GICM-UdeA/Horno-CS/README.md

# Horno-CS
Este proyecto esta encaminado a el diseño y construcción de un horno de secado para celdas solares flexibles. Documentos e información relevante pueden consultarse en la [carpeta compartida][carpeta] de OneDrive de GICM. En este [enlace][docInfo] encontrará los detalles del proyecto que fueron suministrados por el grupo de celdas solares. 

> [!NOTE]
> **Actualización 16-Mayo**  
> Se estudio la forma de construir el Horno propuesto. El desarrollo y resultados de dicho estudio pueden consultarse en el directorio [`concept_test/`](https://github.com/GICM-UdeA/Horno-CS/tree/main/concept-test). Sin embargo, los objetivos del proyecto se cambiaron para enfocarse solamente en desarrollar un sistema de caracterización de los perfiles de temperatura que alcanza un Horno o sistema de radiación. La propuesta y desarrollo de esto último se puede consultar en el directorio [`measurement-system/`](https://github.com/GICM-UdeA/Horno-CS/tree/main/measurement-system).

>**CONTRIBUCIONES Y REPORTE DE PROBLEMAS**
>
> Si eres desarrollador, para tratar de preservar la integridad del repositorio y evitar fallos, por favor seguir las pautas para publicar aportaciones, las cuales se indican en el apartado ["CONTRIBUTING"][contributors]. Si encuentra algún problema dentro del proyecto puede reportarlo abriendo un "issue" de acuerdo con los lineamientos del mismo apartado.



[contributors]: CONTRIBUTING.mb
[docInfo]: https://docs.google.com/document/d/1KgRByXrc8A7OMcjD5w7Hg8IoM0wxuoulxKGeyv_lWE0/edit?usp=sharing
[carpeta]: https://docs.google.com/document/d/1KgRByXrc8A7OMcjD5w7Hg8IoM0wxuoulxKGeyv_lWE0/edit?usp=sharing
