GICM-UdeA/Horno-CS/img/A4988_conection.jpg

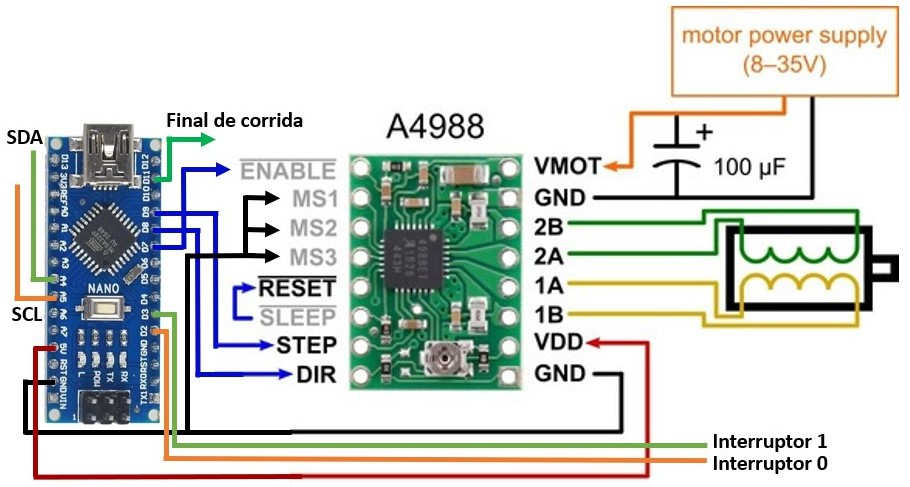
img/A4988_conection.jpg
