GICM-UdeA/Horno-CS/img/master_thermocouple.jpg

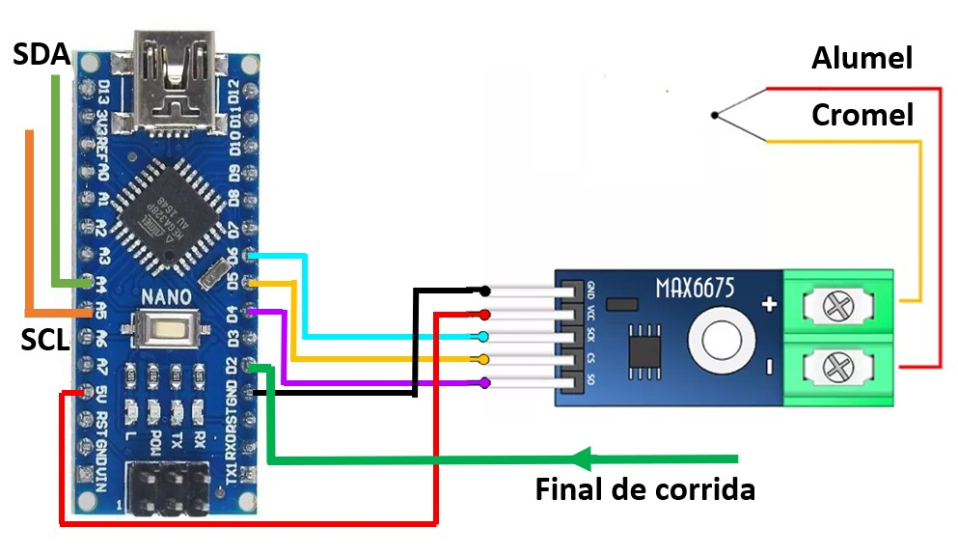
img/master_thermocouple.jpg
