GICM-UdeA/Horno-CS/concept-test/software/interface-py/map_test.png

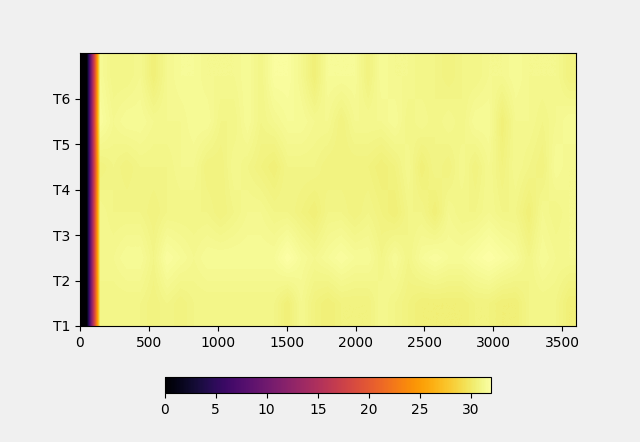
concept-test/software/interface-py/map_test.png
