GICM-UdeA/Horno-CS/concept-test/software/interface-py/plot_test.png

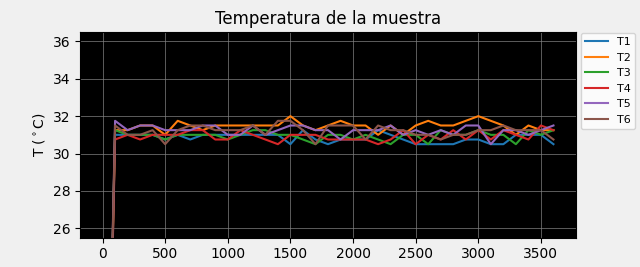
concept-test/software/interface-py/plot_test.png
