GICM-UdeA/Horno-CS/concept-test/software/interface-py/plotPID_test.png

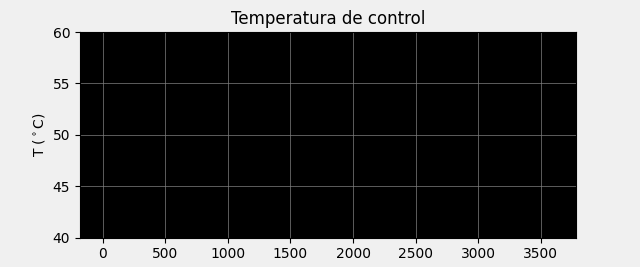
concept-test/software/interface-py/plotPID_test.png
