GICM-UdeA/Horno-CS/concept-test/software/interface-py/results/map_test.png

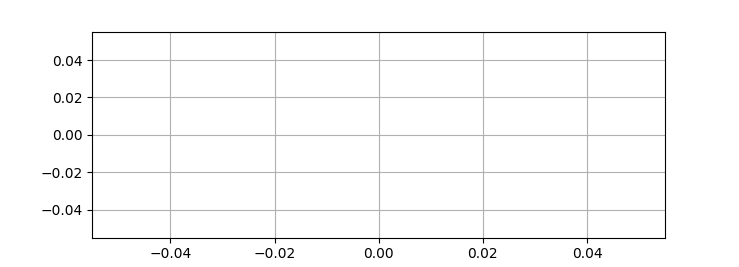
concept-test/software/interface-py/results/map_test.png
