GICM-UdeA/Horno-CS/img/measures1.jpg

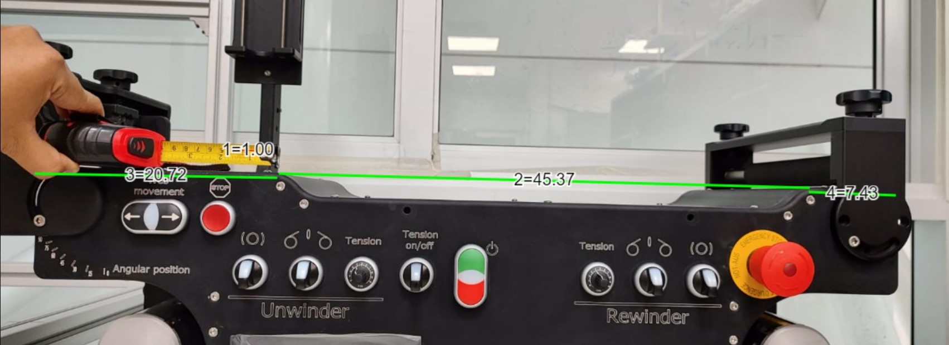
img/measures1.jpg
