GICM-UdeA/Horno-CS/img/measures2.jpg

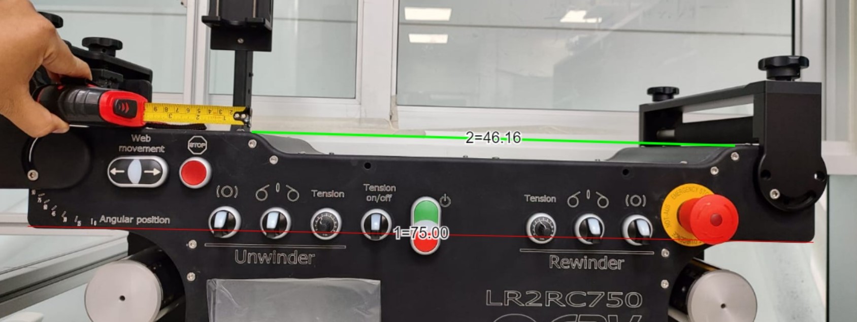
img/measures2.jpg
