GICM-UdeA/Horno-CS/(threads)

Thread 1 (2023-09-09):

Desarrollar Dimmer digital controlado por PWM

DanielEstrada971102, 2023-09-09:
Para el control de la intensidad de la fuente de luz se querría un sistema que pueda ser controlado digitalmente. Se puede implementar un circuito Dimmer con estás características basándose en lo que se ilustra [acá](https://www.learningelectronics.net/circuits/dimmer-with-mosfet.html).

DanielEstrada971102, 2023-09-29:
Se plantea la posibilidad de desarrollar otro montaje basado en este [video](https://www.youtube.com/watch?v=4Dd16clsMxQ)

DanielEstrada971102, 2023-10-24:
Un análisis más detenido del problema permitió notar que dos aspectos muy importantes de este circuito son el Transistor MOSFET que se utilice y/o el optoacoplador. Idealmente se recomienda tratar de apegarse al diseño original de la referencia, ya que estuvimos mucho tiempo atascados para finalmente darnos cuenta que usando el optoacoplador "4n33" en conjunto con el transistor IRF180 no reproduce el comportamiento deseado del circuito.  Esto se debe, básicamente, a que el transistor tiene un requerimiento alto de corriente de GATE que no se satisface, por lo tanto, no se satura el transistor.

Esto se resolvió usando otro Optoacoplador que cumpla el requerimiento del transistor. Al final se utilizó el "PC817" y junto con el IRF, !si funcionó!

Para resolver este problema fue de gran utilidad ver el siguiente hilo de [reddit](https://www.reddit.com/r/AskElectronics/comments/lsnehx/simple_mosfet_pwm_circuit_in_falstad_is_only/).

Básicamente el circuito implementado funciona como esto: [https://tinyurl.com/y7s5d6m3](https://tinyurl.com/y7s5d6m3)

Closed 2023-10-24.

Thread 2 (2023-09-09):

Arreglar el sistema del motor

DanielEstrada971102, 2023-09-09:
EL circuito y el código que controla el motor, y por lo tanto el movimiento de la termocupla con la muestra de PET, se desarrolló y ensayo exitosamente. Sin embargo, luego de un tiempo dejo de trabajar, se sospecha que pudo haberse quemado un componente. Se requiere revisar el sistema y determinar si efectivamente se trata de un cambio de componente electrónico o si por el contrarío se trata de algo en la codificación.

DanielEstrada971102, 2023-09-15:
Después de revisar el circuito no se encontró ningún problema en la electrónica. Inspeccionando el código se notó que el problema radicaba en la forma en la que el dispositivo maestro envía los comandos al esclavo (motor).

Closed 2023-09-15.

Thread 3 (2023-09-09):

Idear un sistema de medición de temperatura en tiempo real para el sustrato de las celdas

DanielEstrada971102, 2023-09-09:
En el sistema final se pretende medir de forma directa la temperatura del sustrato de las celdas solares (PET), para ello se ha considerado diseñar un sistema en forma de rodillo que integre sensores de temperatura al rededor de la circunferencia. De esta forma se mediría la temperatura del PET por contacto directo con el rodillo.

Este diseño representa varios desafíos, el más obvio es el hecho de que si los sensores son cableados, al estar atados en un rodillo giratorio estos se van a retorcer y sería imposible conectarlo a un microcontrolador. La idea hasta ahora, sería diseñar el rodillo hueco, de tal forma que se pueda incrustar en el interior toda la electrónica necesaria.

Esto es un problema abierto, **mejores soluciones pueden ser planteadas**.

DanielEstrada971102, 2024-03-14:
Dado el nuevo enfoque del proyecto, la medición directa en el sustrato de la celda se ha descartado. Por ahora con la caracterización de la radiación con el sistema de termocuplas implementado en #22 será suficiente. Este issue se cierra por el momento.

Closed 2024-03-14.

Thread 5 (2023-09-18):

Rehacer el control de velocidad del motor

DanielEstrada971102, 2023-09-18:
Hasta ahora la velocidad a la que gira el motor, y por ende, la velocidad a la que se mueve la base del motor, se basa en el calculo que indica la ecuación (1) en ["Motor de paso"](concept-test/firmware/Motor_code/README.md). Allí se tiene control de las revoluciones por minuto que se le indican al programa y arduino traduce está información a tamaño de pulso. Se cree que es mejor alternativa idear como modificar el programa para que en lugar de pasarle el valor pwm, se le pase la velocidad en unidades m/min (considere que se quiere un sistea que sea capaz de moverse en el rango 0.05-2.8 m/min.

La idea es que al finalizar, en la interfaz,  se pueda mandar el valor de la velocidad en m/min.

DanielEstrada971102, 2023-09-25:
Al parecer la libreria Stteper.h de arduino integra la funcionalidad de control de velocidad. La idea sería cambiar en el código del motor, la forma en la que se controla la velocidad.

Closed 2024-02-24.

Thread 6 (2023-09-18):

Construir la interfaz para la prueba de conceptos

DanielEstrada971102, 2023-09-18:
Para facilitar la manipulación y visualización de los datos de las pruebas de conceptos, se pensó construir una interfaz grafica para interactuar con el arduino maestro del sistema. La idea sería hacer algo muy simple y fácil de implementar, entonces se puede usar Python o LabView

Closed 2023-09-23.

Thread 7 (2023-09-18):

Incluir los comandos de control del Dimmer en el código del maestro

DanielEstrada971102, 2023-09-18:
Luego de que se resuelva el issue #1 se tendrá que incluir las respectivas opción de control para el subsistema de control de intensidad de radiación. Sería añadir los respectivos comandos a el código [master_code.ino](concept-test/firmware/master_code/master_code.ino).

DanielEstrada971102, 2023-10-24:
Este Issue está contenido en el #10, por lo tanto se cierra acá.

Closed 2023-10-24.

Thread 9 (2023-09-29):

¿Cuál es el precio de horno del LR2RC?

DanielEstrada971102, 2023-09-29:
Consultar el precio de mercado del horno que se requiere para el sistema.

DanielEstrada971102, 2023-09-29:
Consultado en la pagina del proveedor de estos instrumentos InfinityPV, se encuentra el siguiente catálogo:

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

Thread 10 (2023-10-10):

Construir sistema de radiación IR

DanielEstrada971102, 2023-10-10:
Avanzando un paso hacia un versión prototipo más realista del horno, se debe construir un sistema de calentamiento por radiación infrarroja. Para ellos se plantea el montaje de la figura.

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

La potencia de las lamparás se debería poder variar por medio de un circuito tipo Dimmer controlado por el Arduino con señales PWM (ver issue #1 y ver [video](https://www.youtube.com/watch?v=4Dd16clsMxQ)). La idea sería añadir también un control PID a este sistema, de tal forma que se mantenga estable la temperatura configurada (ver [video](https://www.youtube.com/watch?v=NVwsOzVxZAk&t=315s)).

La caracterización del plano de incidencia de la radiación podría tratar de medirse con un Luxómetro, aún hay que pensar más al respecto para tratar de garantizar que toda la superficie reciba la misma intensidad y se caliente uniformemente.

DanielEstrada971102, 2024-01-25:
Usando transistores MOSFET con referencia IRF840 se supera el limite de potencia del encapsulado si se usan más de dos lámparas halógenas (~1kW) . por lo tanto se sugiere usar dos de 500W cómo máximo o añadir al circuito etapas de potencia extra, es decir, un transistor por lámpara a usar. El circuito que se está usando al momento se ilustra en la siguiente imagen:

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

Como puede notarse, se introdujo una etapa de "*switcheo*" extra a través de un transistor 2N2222A, esto, tratado de mitigar el elevado consumo de potencia.

Nota: Los componentes clave que se usan en el circuito de la imagen son solo con fines de simulación, los del circuito real corresponden a los mencionados en #1.

DanielEstrada971102, 2024-01-30:
Para evitar el rediseño del circuito para preparar etapas de potencia para cada lampara por separado, se optó por usar solo dos lámparas halógenas en está etapa de prueba de concepto.

La construcción del horno se logro al fabricar una cavidad metálica (ver figura) en cuyo interior se recubrió con lana de roca como aislante térmico. De esta forma, se han logrado alcanzar temperaturas de más de 200 °C.

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

El sistema de control PID se programo con éxito y presenta el comportamiento deseado. El siguiente paso será calibrarlo para estabilizar las temperaturas "setPoint" y para que las fluctuaciones no sean abruptas.

DanielEstrada971102, 2024-02-01:
resuelto con el commit 0902145

Closed 2024-02-07.

Thread 12 (2024-01-31):

Calibrar el controlador PID del horno

DanielEstrada971102, 2024-01-31:
Como se discutió en el issue #10 , el código de base para el control PID del horno y el prototipo para las pruebas de concepto se desarrollaron de manera exitosa. El siguiente paso será hacer la calibración de los parámetros PID para garantizar un mejor funcionamiento del horno. Luego de esto hay que integrarlo al código principal.

DanielEstrada971102, 2024-03-14:
Dado que el enfoque del proyecto cambio para solo desarrollar un sistema de medición, este issue se cierra por ahora.

Closed 2024-03-14.

Thread 14 (2024-02-07):

Actualizar la interfaz grafica de LabView para control el horno

DanielEstrada971102, 2024-02-07:
Con el issue #10 y el pull-request #13 se deja listo el sistema de radiación o prototipo de Horno. Con esa nueva característica la interfaz debe adaptarse.

Closed 2024-02-24.

Thread 17 (2024-02-24):

Incluir más termocuplas en el sistema de medición

DanielEstrada971102, 2024-02-24:
Apuntando a construir un sistema de medición en tiempo real del mapa de temperaturas en el plano por el que avanza una muestra al atravesar el horno (ver figura), se pretende incluir al sistema de detección `master_code.ino` más entradas de termocuplas. Ante el requerimiento de pines, se cree que es necesario migrar a una tarjeta Arduino Mega.

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

La modificación al código consiste en producir una salida (como respuesta al comando `g`) con la siguiente estructura:
```python
out_data = {"T1": [v1], "T2": [v2], "T3": [v3], "T4": [v4], "T⁵": [v5]}
```
con `[v_i]` la medida de cada termocupla.

DanielEstrada971102, 2024-02-27:
@Sosorio8894, se descartó la necesidad de adquirir el Arduino Mega. Esto, porque los drivers de las termocuplas (MAX6675) se comunican con el microcontrolador a través del protocolo SPI, esto quiere decir que requiere de las tres líneas (cables) de comunicación (SCK, CS, S0 ), de las cuales, dos pueden compartirse entre varios dispositivos esclavos (cada controlador MAX...), y la restante (CS) se conecta en un pin digital del arduino para cada driver. Este pin es el que le permite al arduino escoger con que dispositivo comunicarse.

En este link hay detalles sobre el proceso.
[Multiple-SPI-devices-to-an-arduino-microcontroller](https://www.learningaboutelectronics.com/Articles/Multiple-SPI-devices-to-an-arduino-microcontroller.php)

Pero para una aproximación simplificada se puede ver este post que trata sobre conectar dos MAX6675 al arduino.
[interfacing-multiple-max6675-with-arduino-uno](https://forum.arduino.cc/t/interfacing-multiple-max6675-with-arduino-uno/960114/4)

Closed 2024-03-07.

Thread 18 (2024-02-24):

Adapatar la interfaz grafica de Python

DanielEstrada971102, 2024-02-24:
De acuerdo al cambio que se propone implementar en #17, se requiere adaptar la interfaz grafica de 9dc777bea4f70c6b5ba27701f98c738ac80f15bf. Se debe producir el mapa de temperaturas a lo largo del movimiento de la muestra al atravesar el horno.

Closed 2024-03-18.

Thread 20 (2024-02-29):

Modificar la librería MAX6675

DanielEstrada971102, 2024-02-29:
Dado que la librería max6675 de Adafruit no utiliza de forma directa la librería SPI de Arduino, no permite hacer una conexión directa de varios dispositivos SPI esclavos para resolver el issue #17. Se hace necesario entonces, crear una clase personalizada que resuelva el problema. La modificación a hacer es la propuesta en este [foro](https://arduino.stackexchange.com/questions/37193/multiple-3-wire-spi-sensor-interfacing-with-arduino)

Closed 2024-02-29.

Thread 23 (2024-03-14):

Diseñar la PCB universal

DanielEstrada971102, 2024-03-14:
Dada las limitaciones de tiempo, el circuito final se debe implementar en una PCB universal. Para ello se propone hacer un esquema del diseño que tendrá el circuito para poder planear la compra de materiales, incluyendo el tipo de conexiones y las medidas de la caja que contendrá el sistema.

Para el diseño se propone usar softwares como [atarado soft circuit editor](https://bricotronika.blogspot.com/2015/09/atarado-soft-circuit-editor.html) o [DIY Layout creator](https://diy-fever.com/software/diylc/), que permiten hacer diseños como

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

Adicional al PCB se debe planear la compra de una caja plástica para guardar el sistema y cómo se deben hacer las perforaciones.

DanielEstrada971102, 2024-03-20:
Se vuelve a abrir este issue debido a un cambió que debe hacerse en el diseño. Debido a la dificultad para encontrar conectores de termocupla a buen precio, se decide implementar la conexión por medio de un conector DB15.

Closed 2024-03-20.

Thread 24 (2024-03-14):

Cotizar y comprar materiales

DanielEstrada971102, 2024-03-14:
Cuando se resuelva el issue #23, debe hacerse rápidamente el proceso de cotización y compra de componentes y materiales.

DanielEstrada971102, 2024-03-16:
@Sosorio8894 con la publicación del Pull-request #30, se establecieron los materiales a comprar. Puedes proceder con la cotización de estos. Acá dejo de nuevo la lista.

- [ ] 1 Caja plástica para proyectos ~12 x 12 ( i+d 150x95x50mm)
- [ ] 1 Circuito impreso universal 5x7cm PCB-BQ-7X5
- [ ] 1 MJ180CH Jack DC De Chasis 2.1×5.5mm
- [ ] 1 ADAPTADOR DE VOLTAJE 5V 2A CONECTOR JACK 5.5 mm
- [ ] 1 Bornera Macho Para PCB De 2 Pines
- [ ] 1 interruptor - Switch balancín mini 2 pines
- [ ] 10 conectores Header hembra 6 pines - 2.54mm (0.1 inch)
- [ ] 3 conectores Header hembra 6 pines - 2.54mm (0.1 inch)
- [ ] 1 metro de temoencogible 2 cm
- [ ] 6 módulos MAX6675
- [ ] 7 termocupla tipo k
- [ ] 6 Conectores de termopar de montaje en Panel - hembra (tipo k)
- [ ] 7 (x10 unidades c/u) cables hembra-macho dupont 10cm. Ver si hay monocolor, si sí, dos monocolor al menos.
- [ ] 1 modulo Bluetooth HC05
- [ ] 2 metro de cable UTP (cable rígido)
- [ ] 6 Separadores (pilares) plástico M/H M4 de 10mm
- [ ] 6 Tuerca plástica M4
- [ ] 4 Separador plástico M/H M2 de 6mm
- [ ] 4 Tuerca metálica para tornillo M2
- [ ] 2 Fresa de tungsteno para CNC 1mm
- [ ] 1 SINTESOLDA Pegante epóxico
- [ ] 1 cinta doble cara

DanielEstrada971102, 2024-03-22:
De la lista mencionada solo falta comprar:

- [ ] 1 SINTESOLDA Pegante epóxico
- [ ] 1 cinta doble cara
- [ ] 1 conector [DB15](https://suconel.com/product/conector-db15-hembra-de-15-pines-rs15h/) hembra 2 hileras

Closed 2024-04-10.

Thread 25 (2024-03-14):

Armar la PCB del sistema, poner en su caja y diseñar las pegatinas decorativas

DanielEstrada971102, 2024-03-14:
Se debe ensamblar el sistema diseñado en #23 y poner en una caja del tamaño apropiado.

Adicionalmente se debe diseñar algunas laminas decorativas que se peguen al sistema con el Logo e información del grupo.

Closed 2024-04-17.

Thread 26 (2024-03-14):

Diseñar membrana o soporte para el arreglo de termocuplas

DanielEstrada971102, 2024-03-14:
La idea para el sistema es censar en tiempo real la temperatura de la cavidad del horno a través de un arreglo de termocuplas con geometría no restringida. Es decir, que las termocuplas puedan organizarse en la geometría que se desee. Para ello se plantea el diseño o la construcción de una membrana agujereada de forma regular, de tal forma que los diferentes termopares se puedan organizar en los agujeros a conveniencia. En arreglos por ejemplo de 2x3, 3x2, 6x1, etc. . El material puede ser el mismo PET provisto por el grupo de celdas, esto con el fin de tener una estructura liviana y que en principio soporte la temperatura que será aplicada.

NOTA: se puede considerara la necesidad de pintar la membrana de negro mate junto con las termocuplas, esto para tratar de optimizar la absorción de radiación.

Thread 27 (2024-03-14):

Implementar el Firmware definitivo del sistema de medición de temperatura.

DanielEstrada971102, 2024-03-14:
El código a implementar en el Arduino debe satisfacer los siguientes requerimientos.

* Monitorear hasta 6 termocuplas tipo k (amplificadas por el módulo MAX6675) de forma eficiente usando el protocolo SPI.
* Comiscarse por protocolo serial con la computadora para enviar los registros de temperatura al recibir el comando "g". Cómo respuesta a esa petición, el sistema debe responder con la siguiente estructura.
  ```python
  {"T1": [T1 value], "T2": [T2 value], "T3": [T3 value], "T4": [T4 value], "T5": [T5 value], "T6": [T6 value]}
  ```
* Dependiendo de lo que se defina posteriormente, podría llegar a ser necesario implementar la comunicación via Bluetooth.

NOTA: La implementación de un código definitivo implicará, por supuesto, tener una versión de firmware capaz de controlar todo el sistema de movimiento y control del Horno. Esto para poder testear el sistema.

DanielEstrada971102, 2024-03-19:
Apuntando a escribir algo optimizado se puede plantear el almacenamiento de las mediciones en una cola de memoria con [ArduinoQueue](https://github.com/EinarArnason/ArduinoQueue)

Closed 2024-04-06.

Thread 28 (2024-03-14):

Implementar la interfaz gráfica definitiva para el sistema

DanielEstrada971102, 2024-03-14:
La interfaz gráfica debe satisfacer los siguientes requerimientos:

* Estar desarrollada en Python usando PyQt5.
* El usuario de poder seleccionar el puerto de comunicación serial. Se debe dejar un valor por defecto por practicidad, y debe haber un proceso de validación que indique la conexión fue exitosa.
* Debe tener un botón u otro widget para comenzar la toma de datos que registra el Arduino.
* Debe contener campos editables para establecer los parámetros utilizados en los experimentos. Por ejemplo: Nombre o ID del experimento, Velocidad con la cual se movió la banda del R2R, % o potencia de la radiación aplicada, frecuencia del pulso IR, fecha y hora del experimento, etc.
* Debe tener un panel para la extracción de los datos obtenidos. Se debe poder producir un archivo Excel por ejemplo, con todos los datos recolectados. Y se debe proporcionar la opción de limpiar las graficas y datos para iniciar una nueva toma de datos.

Un esquema ilustrativo de a lo que se quiere llegar se muestra a continuación:

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

Closed 2024-04-10.

Thread 29 (2024-03-14):

Caracterizar las limitaciones del sistema

DanielEstrada971102, 2024-03-14:
Una vez resuelto #27, es necesario idear pruebas para determinar las variables relevantes que caracterizan la resolución y limites del sistema. Es importante estimar el **delay** temporal entre el registro de dos mediciones de temperatura consecutiva (entre una termocupla y otra). Es también necesario, ver el tiempo mínimo que requiere hacer dos mediciones completas consecutivas (las 6 termocuplas). Se debe pensar si es necesario determinar otras características.

Este proceso debe ser riguroso y debe quedar bien DOCUMENTADO. Ya que hará parte de las especificaciones técnicas que se entreguen al final.

Thread 35 (2024-04-18):

Errores en la toma de datos medición

Sosorio8894, 2024-04-18:
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

Sosorio8894, 2024-04-18:
Se modifico el valor inicial de 30 (Buffer size) por 40. Se tomaron 4 mediciones de 15000 ms posiblemente deja tomar más datos. Y presenta novedad en la termocupla T5 la cual arrojo valores superiores a 1000 °C y valores mínimos de 0 °C.

Sosorio8894, 2024-04-18:
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

Se realizar 6 mediciones de 10000 ms teniendo en cuenta los parámetros iniciales sampling rate = 240 ms, plotting rate = 50 ms, buffer size = 30.

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

Al cambiar el analysis time de 10000 ms a 15000 ms el sistema se interrumpe por llenado del buffer. Si se reestablece a 10000 ms se puede continuar tomando datos.

Sosorio8894, 2024-04-19:
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

Corroborando los datos guardados se observa que el plotting rate no ubica los puntos de acuerdo al valor establecido, si no con el valor del sampling rate.
