GICM-UdeA/Horno-CS/measurement-system/hardware/PCB-layout/PCB.pdf

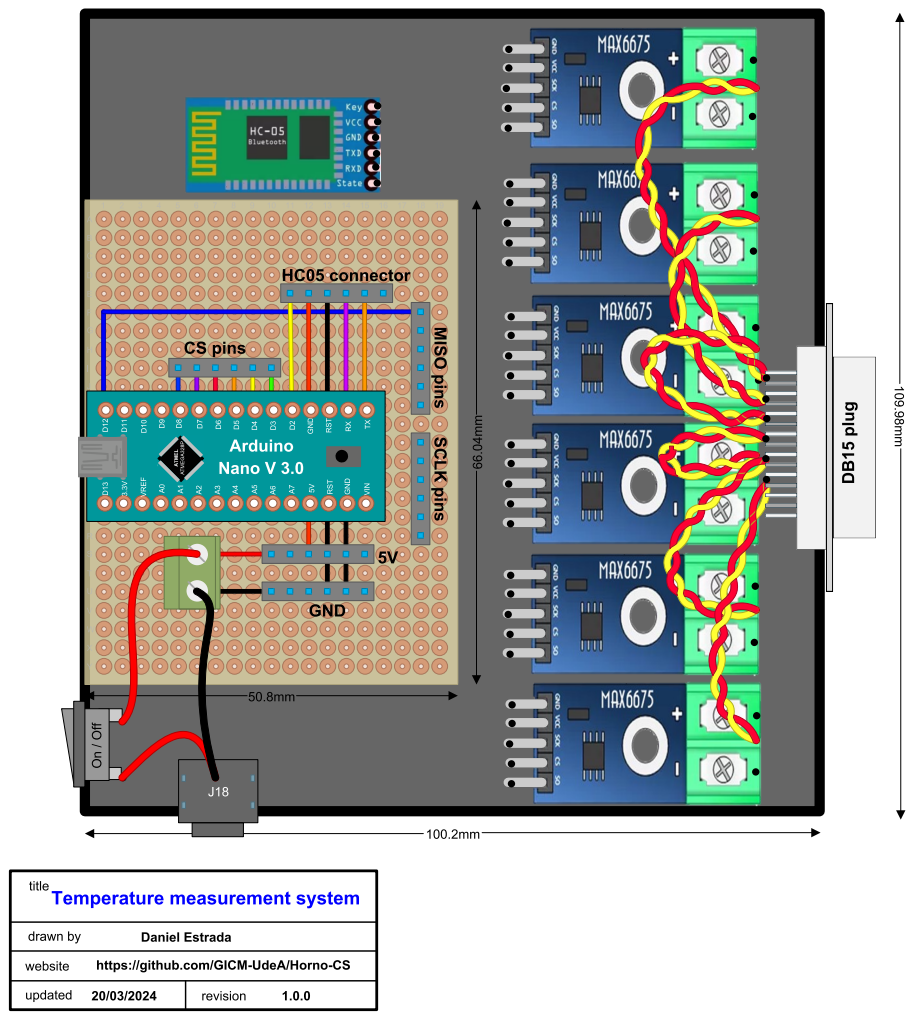
[picture p12: page 1]
