GICM-UdeA/Horno-CS/(commit log)

2023-09-08 Add stepper motor code, master controler code and README files
    Add stepper motor code and README
    Add master controler code and README
2024-02-07 Build an IR radiation system - oven prototipe
    * Add basic PID code for the oven control
    * Change PID control for the PID arduino library
    * Add an extra thermocuple to monitor oven temperature
    * Add PID control for the oven
    ---------
2024-02-24 Cambiar el controlador del motor (#15)
    * Engine speed control was carried out.
    * Add a new file for test
    * Chage speed controler to use AccelStepper library
    By using this library the complete control over the movement of the motor was achived. End of line interrupts are not needed anymore.
    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
2024-02-24 Create a PyQt based GUI To control oven and motor, and aditionally, to plot temperature mesurements in real time.
2024-02-29 Add my_max6675 library To be able to connect several thermocouples via SPI
2024-03-07 Incluir más termocuplas en el sistema de medición (#22)
    Add 5 thermocouples to the measurement system
    #This is a squash of commits
    #* Add 5 thermocouple measurement system
    #* Add 5 thermocouple measurement system
    #* Remove leftover include and variable statements
    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
2024-03-13 Add an extre thermocouple and Chande de pin order
2024-03-16 Create the PCB Layout for the project
2024-03-18 Add 6 temperature probes to the GUI
    update gitignore file
    Add several temperature probes (5) to monitoring
    This version does not work propertly, the imshow plot is not well.
    Add 6 temperature probes to map the oven
    [main.py, mplwidget.py]
2024-03-20 Change Thermocouple connectors to DB15 Plug
