GICM-UdeA/Horno-CS/(notices)

Notices in the files:
README.md:
License: CC0-1.0
